ryood/Arduino_EG/CameraZOOM-20180806190456735.jpg

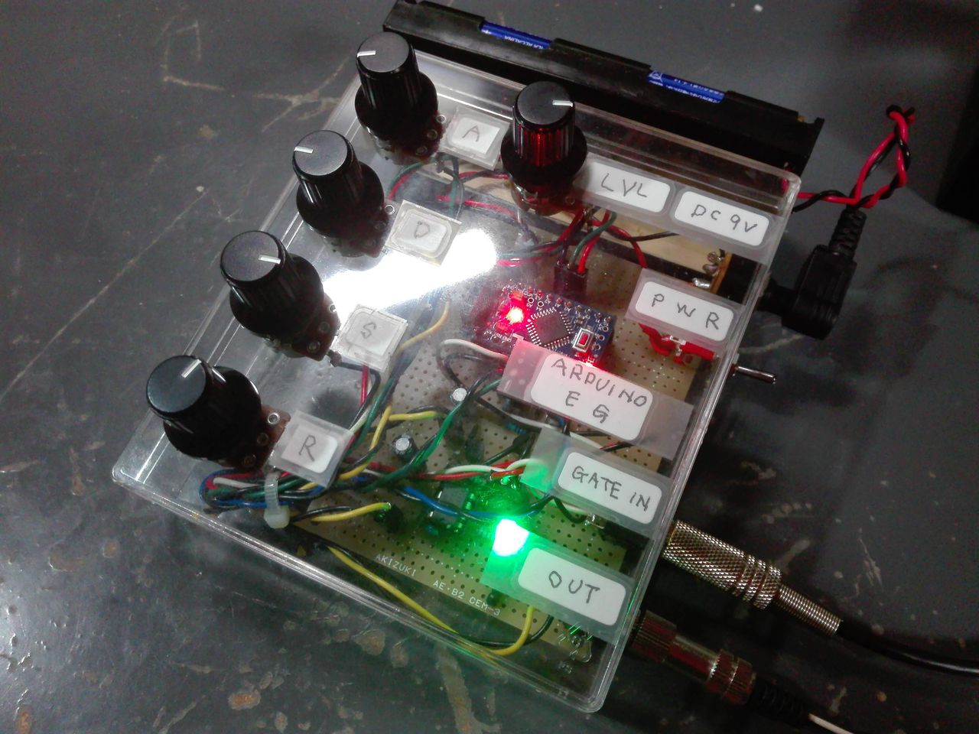
CameraZOOM-20180806190456735.jpg
