ryood/Arduino_EG/Arduino_EG_ケース内配線_ブレッドボード.png

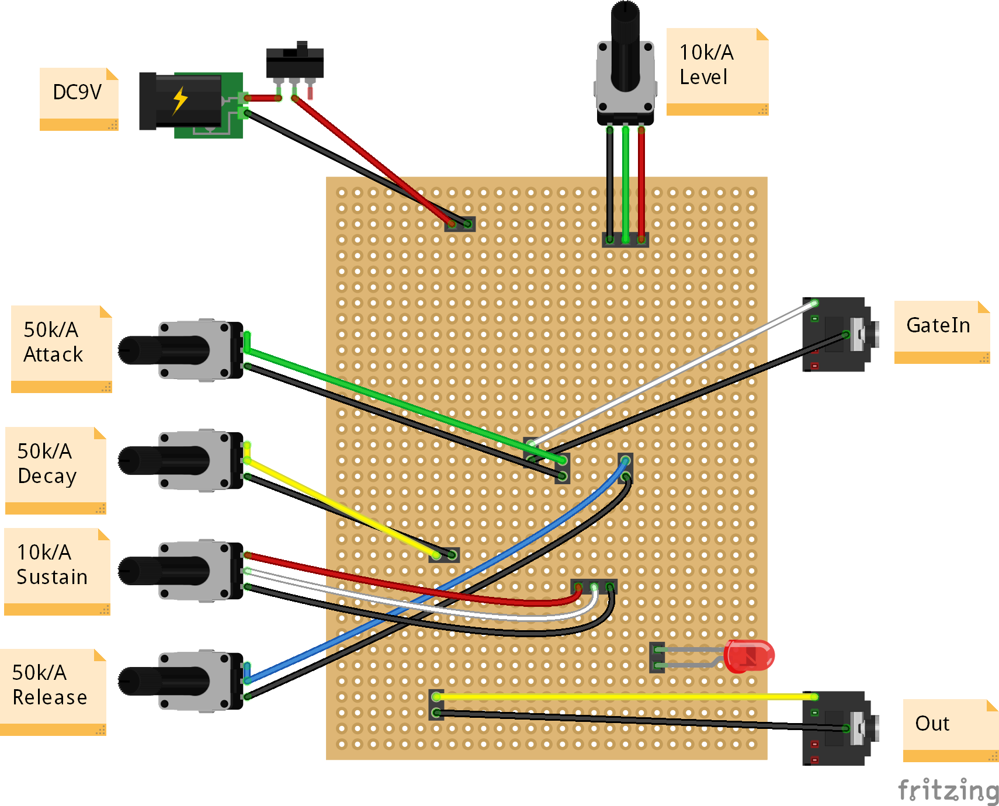
Arduino_EG_ケース内配線_ブレッドボード.png
