ryood/Arduino_EG/eagle/Arduino_EG_brd.png

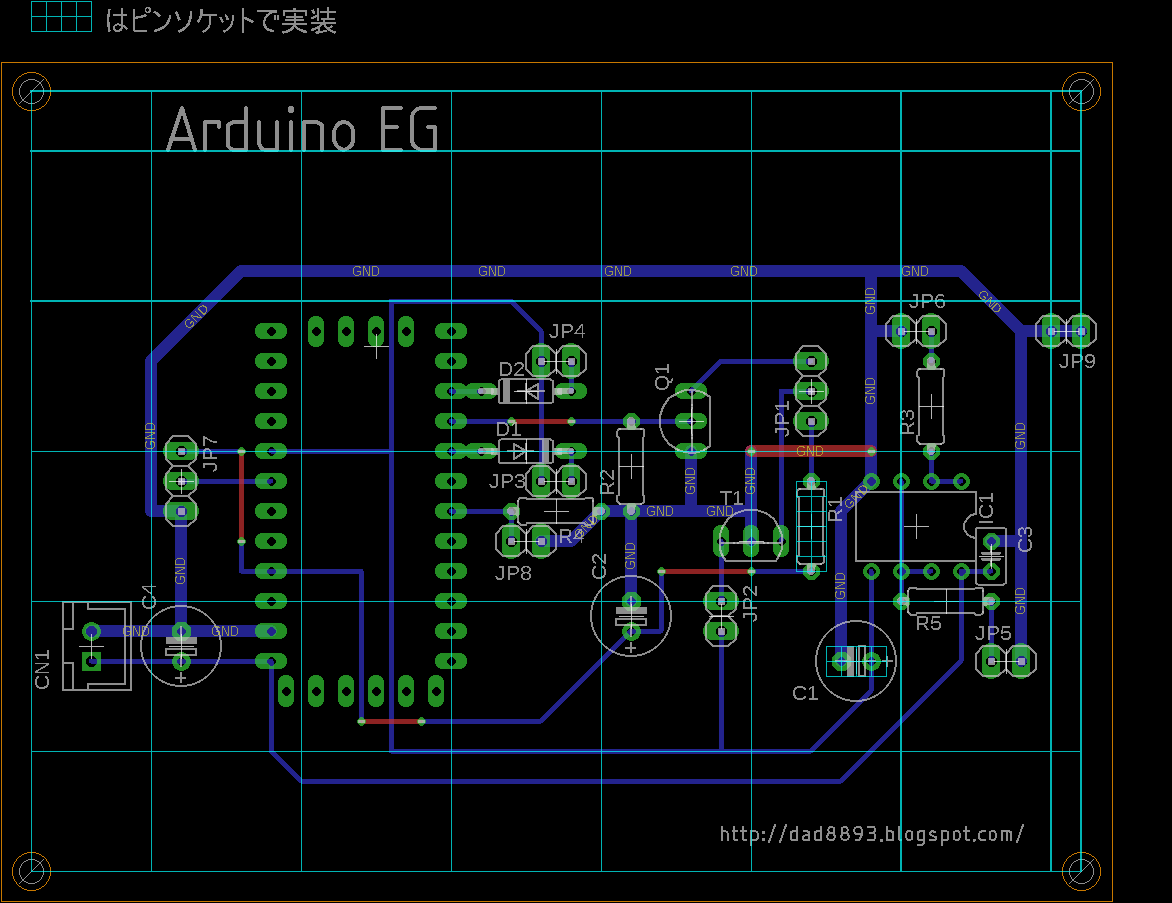
eagle/Arduino_EG_brd.png
