ryood/Arduino_EG/eagle/Arduino_EG_sch.png

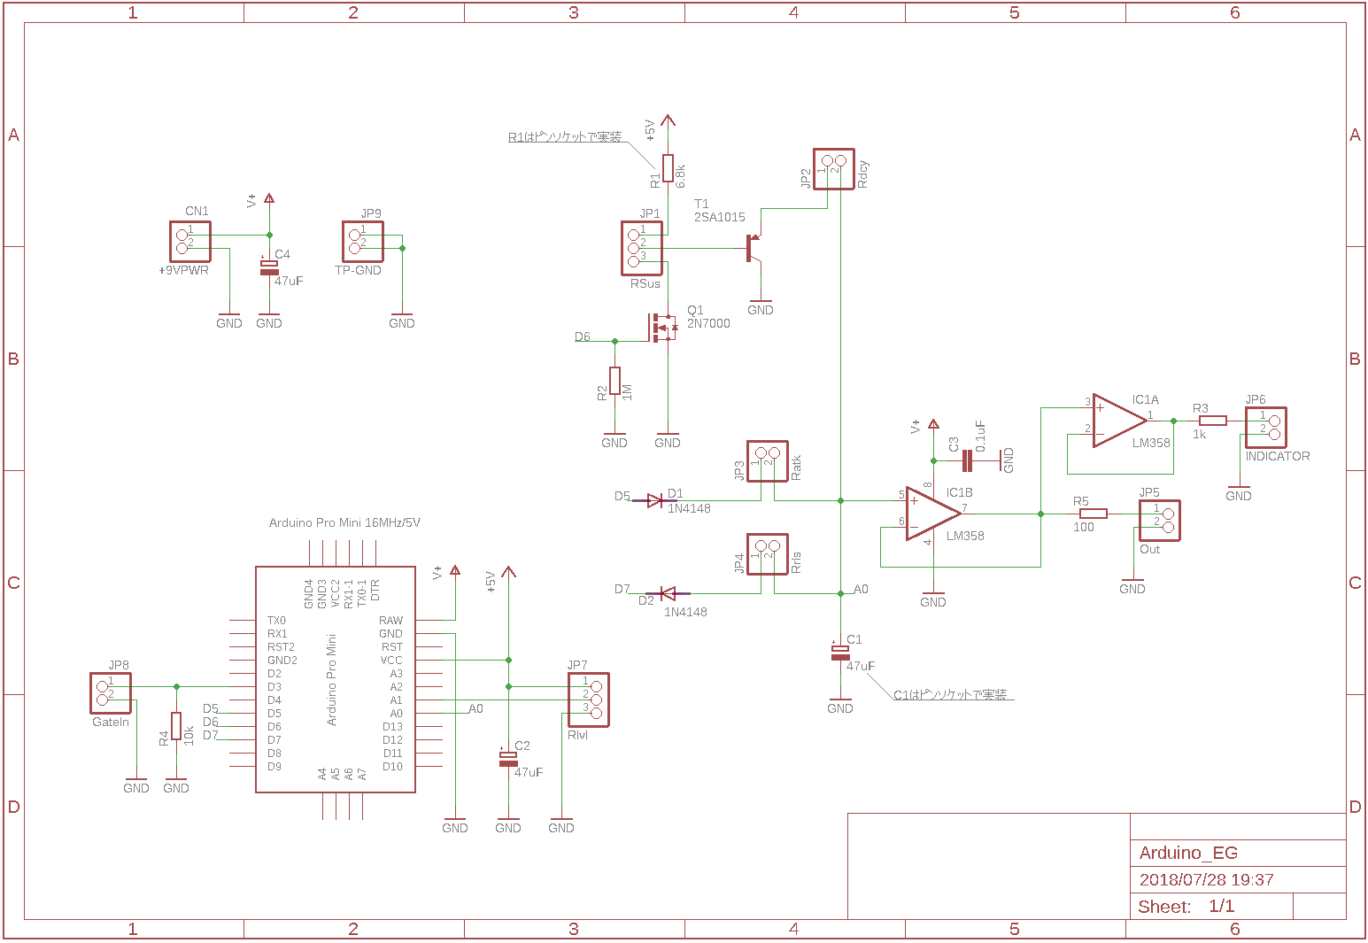
eagle/Arduino_EG_sch.png
