ryood/Arduino_EG/Envelope Generator Curve.png

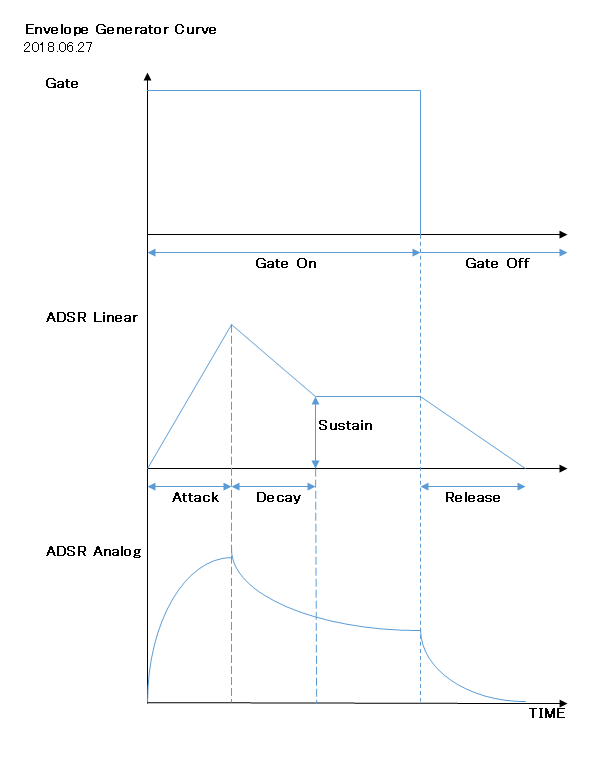
Envelope Generator Curve.png
