ryood/Arduino_EG/fritzing/Arduino_EG_r2_ブレッドボード.png

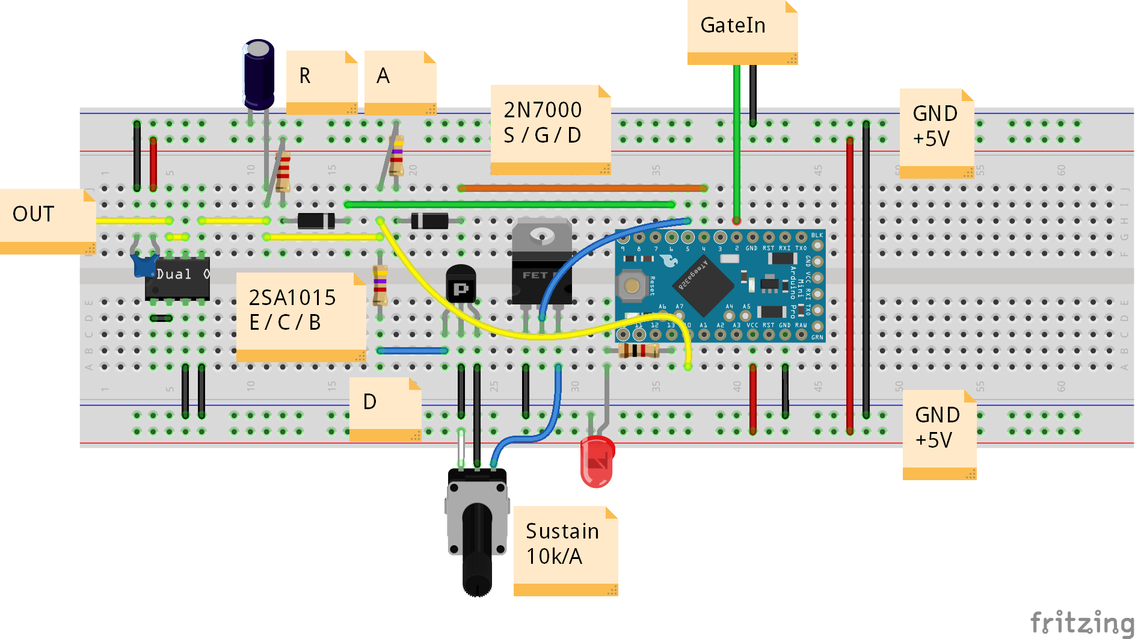
fritzing/Arduino_EG_r2_ブレッドボード.png
