ryood/Arduino_EG/fritzing/Arduino_EG_r3_ブレッドボード.png

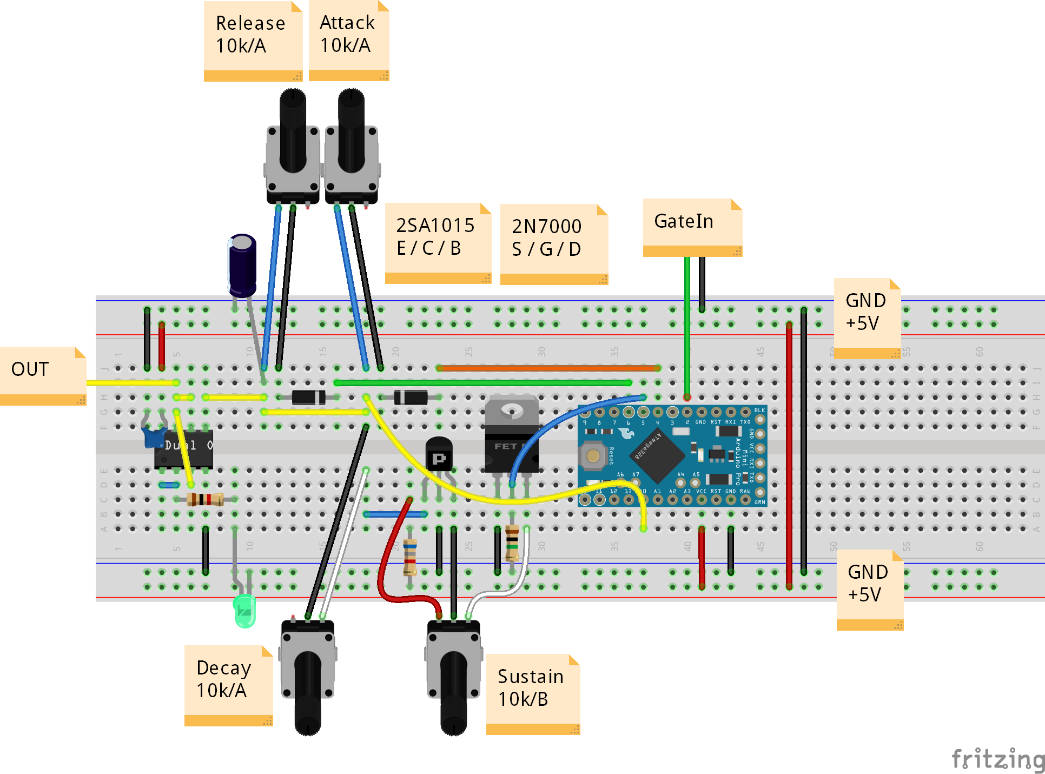
fritzing/Arduino_EG_r3_ブレッドボード.png
