ryood/Arduino_EG/資料/907-cont-gen-key-schem.gif

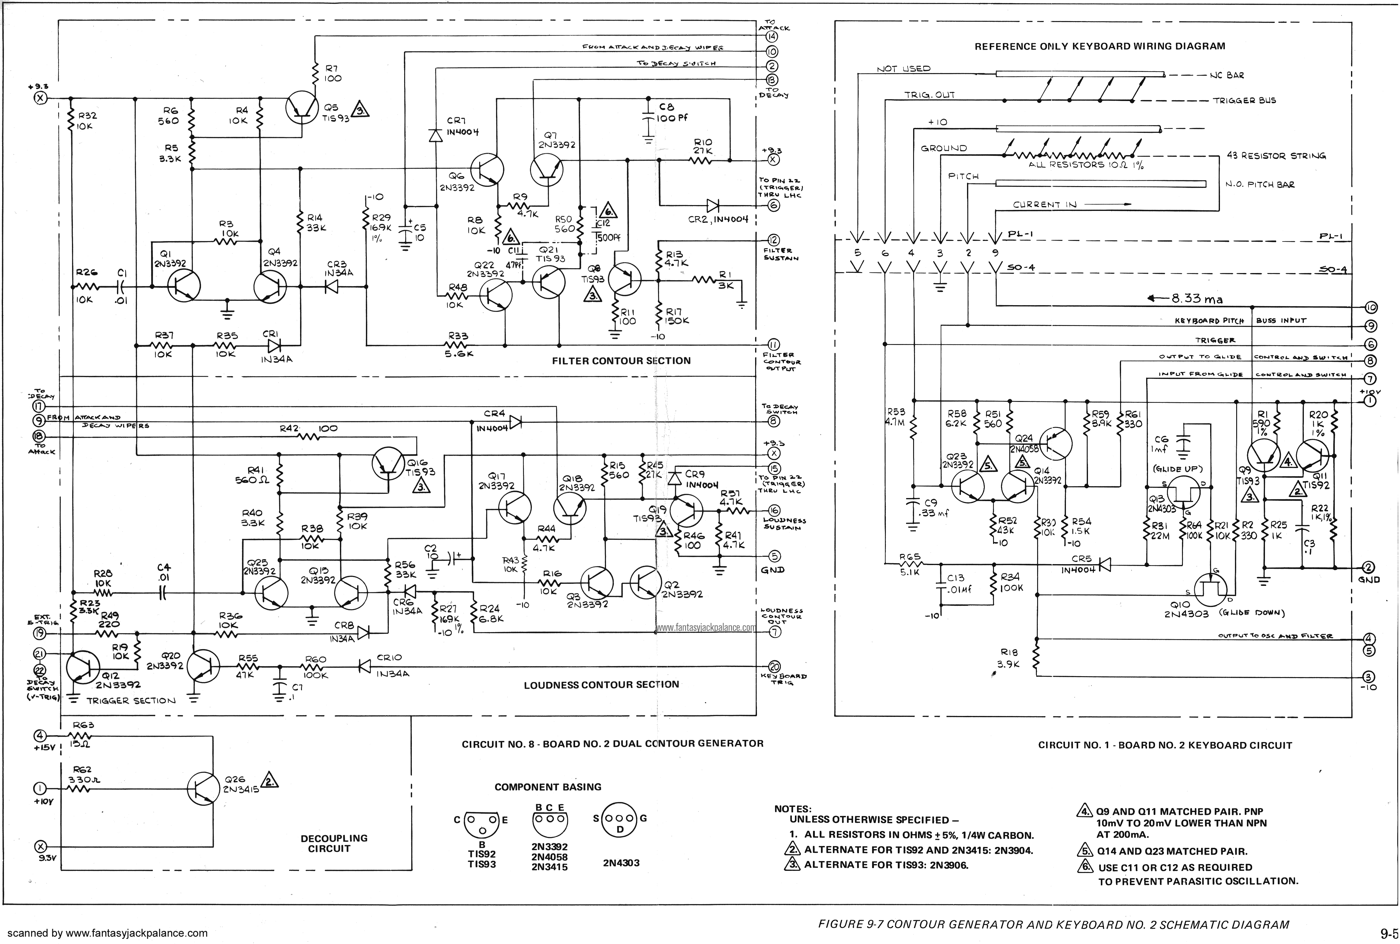
資料/907-cont-gen-key-schem.gif
