ryood/Arduino_EG/資料/ADSR555-sch.gif

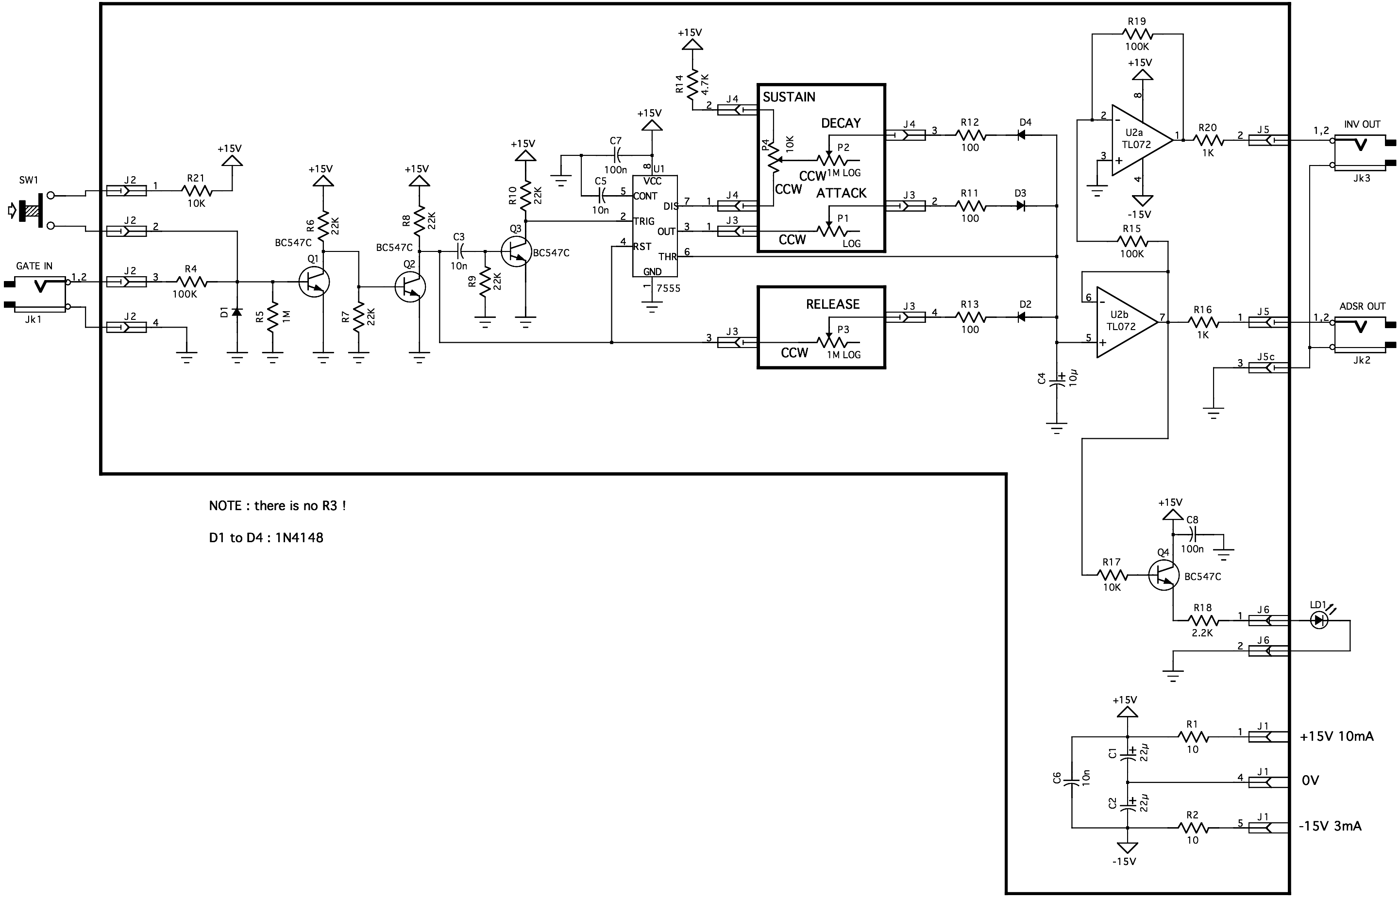
資料/ADSR555-sch.gif
