ryood/Arduino_EG/資料/adsr_160.jpg

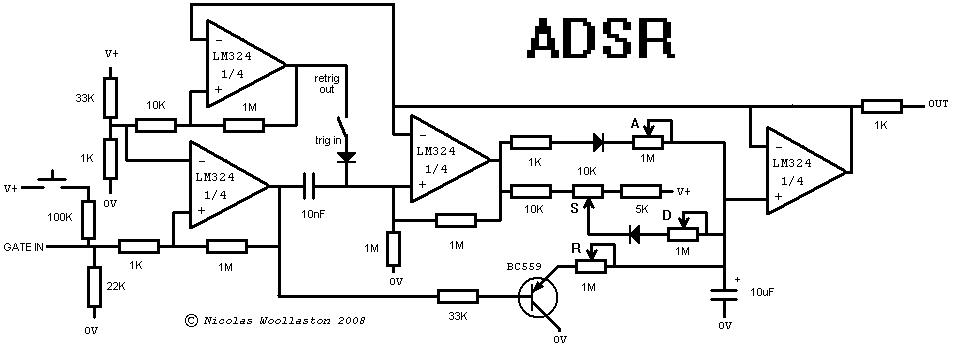
資料/adsr_160.jpg
