ryood/Arduino_EG/資料/switching-and-timing.png

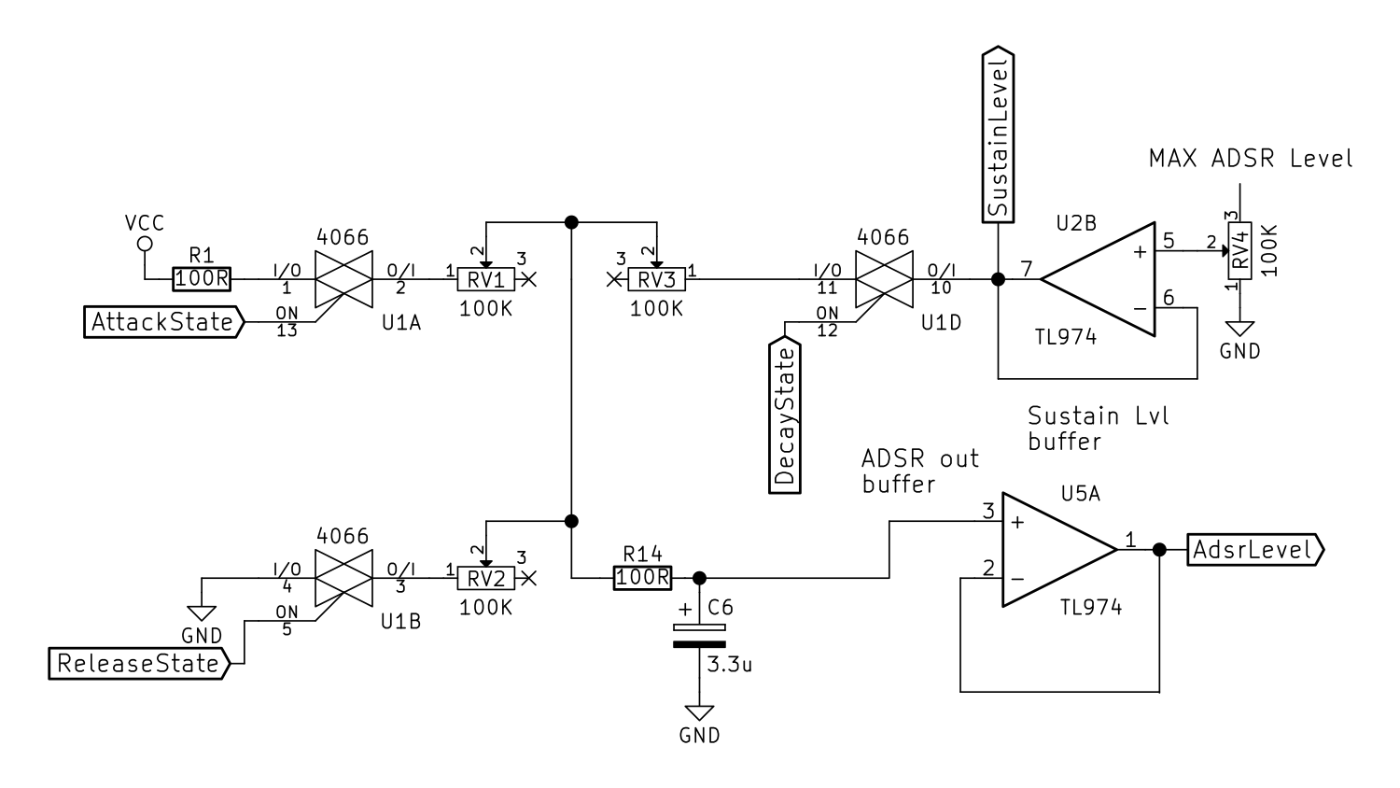
資料/switching-and-timing.png
