ryood/Arduino_EG/(list of files, cad)

Other CAD files:
case/Arduino_EG_Case.dwg
case/Arduino_EG_Case_Top.dwg
