ryood/Arduino_EG/spice/StepWave_LPF_EG.asc

C1: cap; 10uF
R1: res; 10k
V1: voltage; PWL(0 0 0.1 0 0.101 5 0.3 5 0.301 2 0.6 2 0.601 0)
Named nets: 0, OUT, IN
.tran 1
