ryood/Arduino_EG/spice/Arduino_EG_Charge_Test.asc

B1: bv; V=5-V(Gate)
C1: cap; 22u
D1: diode; 1N4148
R1: res; 100
R2: res; {Rattack}
S1: sw
V3: voltage; PULSE(0 5 0 1n 1n 0.8 1)
Named nets: Discharge, Gate, 0, OUT
.step param Rattack 10k 1k
.tran 0 10 8
.Model SW SW(Ron=10m Roff=10meg Vt=2.5)
