ryood/Arduino_EG/spice/Arduino_EG_Analog_MOS-FET.asc

B1: bv; V=5-V(Attack)
C1: cap; 22u
D1: diode; 1N4148
D2: diode; 1N4148
M1: nmos; 2N7002
Q1: pnp; QA1015
R1: res; {Rdecay}
R2: res; {Rattack}
R3: res; {15k-Rsustain}
R4: res; {Rsustain}
R5: res; {Rrelease}
R6: res; 10k
U1: UniversalOpamp2
V1: voltage; 5
V2: voltage; PULSE(0 5 0 1n 1n 0.4 0.5)
V3: voltage; PULSE(0 5 0 1n 1n 0.1 0.5)
Named nets: InvAttack, Attack, 0, OUT, VCC, Gate
.param Rattack 4.7k
.tran 0 10 9
.Model SW SW(Ron=10m Roff=10meg Vt=2.5)
.param Rdecay 2.2k
.param Rsustain 4k
.param Rrelease 2.2k
