ryood/Arduino_EG/spice/555_Monostable.asc

C2: cap; {CL}
R1: res; {RL}
R2: res; {RA}
U1: NE555
V1: voltage; 5
V2: voltage; PULSE(0 5 0 1n 1n 0.25m 0.3m)
Named nets: 0, IN, OUT, VCC
.param RA 9.1k
.param CL 0.01u
.param RL 1k
.tran 0 10m 9m
