ryood/Arduino_EG/spice/EG_Analog2_0.asc

C1: cap; 47u
C2: cap; 0.001u
C3: cap; 0.01u
D1: diode; 1N4148
D2: diode; 1N4148
D3: diode; 1N4148
D4: diode; 1N4148
Q1: pnp; QA1015
Q2: npn; QC1815
Q3: npn; QC1815
Q4: npn; QC1815
Q5: npn; QC1815
R1: res; {Rdecay}
R2: res; {Rattack}
R3: res; {Rrelease}
R4: res; {75k-Rsustain}
R5: res; {Rsustain}
R6: res; 10k
R7: res; 2.2k
R8: res; 2.2k
R9: res; 47k
R10: res; 2.2k
R11: res; 10k
R12: res; 2.2k
R13: res; 22k
R14: res; 47k
R15: res; 10k
R16: res; 4.7k
U1: NE555
U2: UniversalOpamp2
V1: voltage; 12
V2: voltage; PULSE(0 12 0 1n 1n 0.5 1)
Named nets: 555Discharge, 0, 555Out, Q4Out, VCC, Out, OUT, Gate, VEE
.param Rdecay 2k
.param Rattack 2k
.param Rrelease 2k
.tran 0 10 7
.step param Rsustain 50k 1k
