ryood/Arduino_EG/spice/EG_Analog2_0_analog.asc

B1: bv; V=V(VCC)-V(Attack)
C1: cap; 47u
D1: diode; 1N4148
D2: diode; 1N4148
Q1: pnp; QA1015
Q2: npn; QC1815
Q3: npn; QC1815
R1: res; {Rdecay}
R2: res; {Rattack}
R3: res; {Rrelease}
R4: res; {75k-Rsustain}
R5: res; {Rsustain}
V1: voltage; 12
V3: voltage; PULSE(0 12 0 1n 1n 0.2 1)
V4: voltage; PULSE(0 12 0 1n 1n 0.75 1)
Named nets: InvAttack, 0, Attack, GATE, VCC, Out, Gate
.param Rdecay 2k
.param Rattack 2k
.param Rrelease 2k
.tran 0 100 97
.step param Rsustain 50k 1k
.param V+ 12
