ryood/Arduino_EG/spice/bak/EG_Analog2_0_analog_9V.asc

B1: bv; V=V(VCC)-V(Attack)
C1: cap; 47u
D1: diode; 1N4148
D2: diode; 1N4148
Q1: pnp; QA1015
Q2: npn; QC1815
Q3: npn
R1: res; {Rdecay}
R2: res; {Rattack}
R3: res; {Rrelease}
R4: res; {100k-Rsustain}
R5: res; {Rsustain}
R6: res; 4.7k
V1: voltage; 9
V3: voltage; PULSE(0 9 0 1n 1n 0.2 1)
V4: voltage; PULSE(0 9 0 1n 1n 0.75 1)
Named nets: InvAttack, 0, Attack, GATE, VCC, Out, Gate
.param Rdecay 1k
.param Rattack 2k
.param Rrelease 2k
.tran 0 100 97
.step param Rsustain list 1k 10k 20k 30k 40k 49k
