ryood/Arduino_EG/spice/bak/EG_Analog2_0_analog_mosfet_9V_EmitterFollower.asc

B1: bv; V=V(VCC)-V(Attack)
C1: cap; 22u
C2: cap; 100u
D1: diode; 1N4148
D2: diode; 1N4148
M1: nmos; 2N7002
Q1: npn; QC1815
Q2: npn
R1: res; {Rdecay}
R2: res; {Rattack}
R3: res; {Rrelease}
R4: res; {100k-Rsustain}
R5: res; {Rsustain}
R6: res; 1k
R7: res; 100k
R8: res; 1k
V1: voltage; 9
V3: voltage; PULSE(0 9 0 1n 1n 0.2 1)
V4: voltage; PULSE(0 9 0 1n 1n 0.75 1)
Named nets: InvAttack, Attack, GATE, 0, Out, VCC, Gate
.param Rdecay 2k
.param Rattack 2k
.param Rrelease 2k
.tran 0 100 98
.step param Rsustain list 1k 25k 50k 75k 99k
.param V+ 12
