ryood/Arduino_EG/(list of files, drawings)

Other design files:
fritzing/Arduino_EG.fzz
fritzing/Arduino_EG_Attack_Charge_Test.fzz
fritzing/Arduino_EG_Impl_Test.fzz
fritzing/Arduino_EG_r2.fzz
fritzing/Arduino_EG_r3.fzz
fritzing/Arduino_EG_ケース内配線.fzz
