ryood/Arduino_EG/fritzing/Arduino_EG_Attack_Charge_Test_ブレッドボード.png

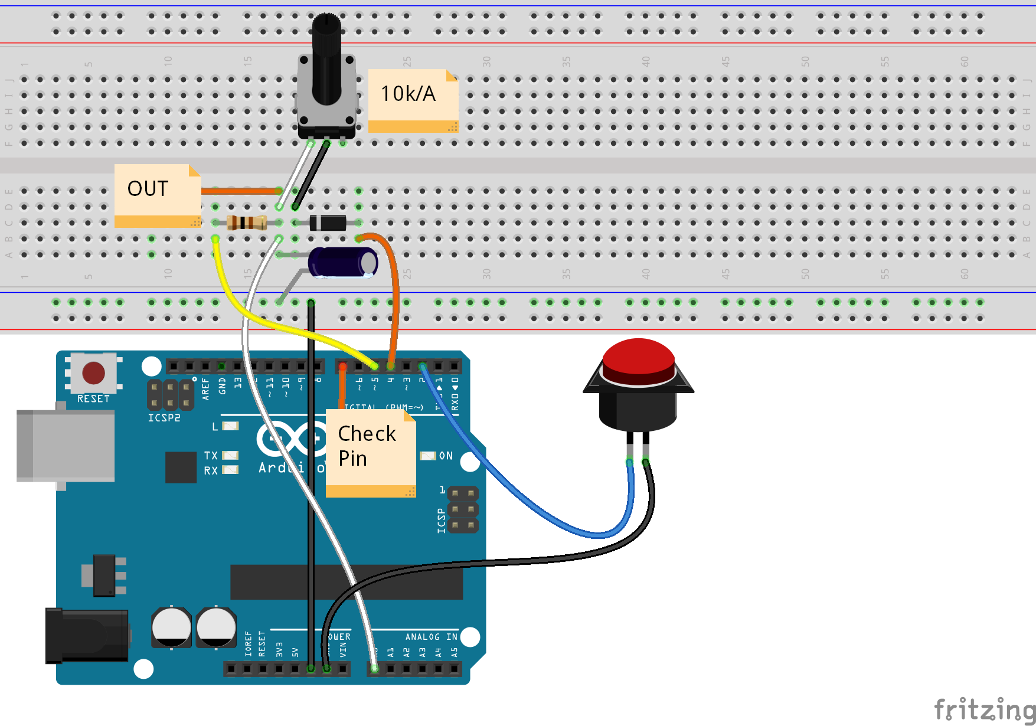
fritzing/Arduino_EG_Attack_Charge_Test_ブレッドボード.png
