ryood/Arduino_EG/fritzing/Arduino_EG_Impl_Test_ブレッドボード.png

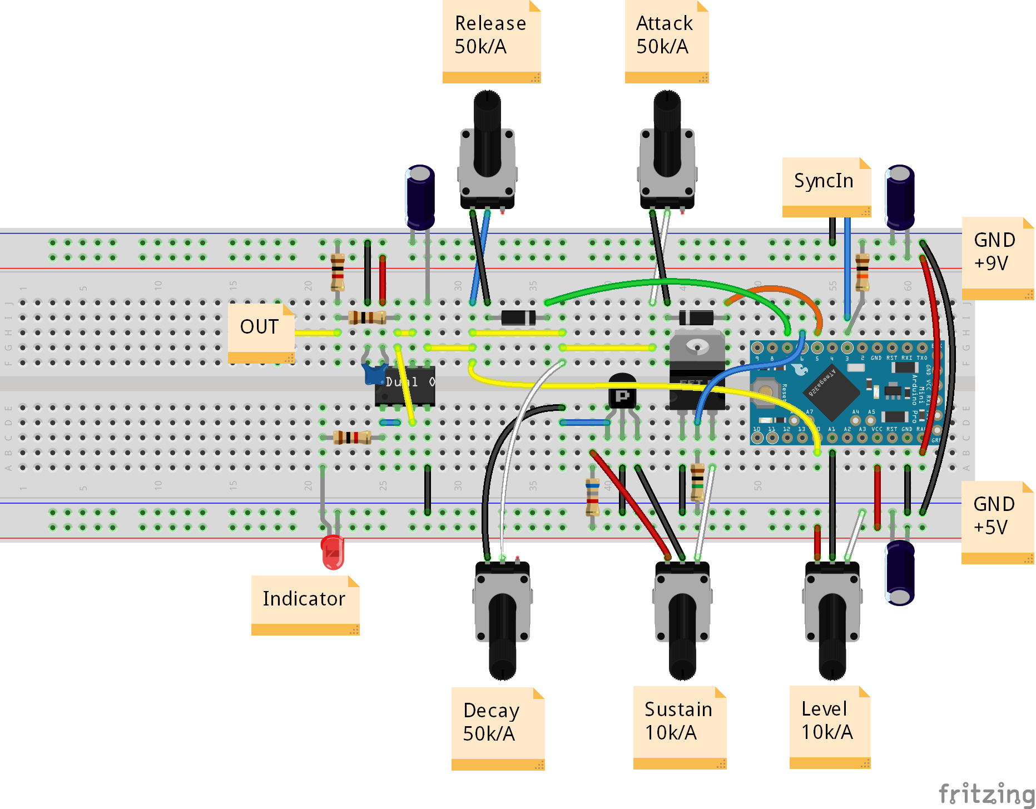
fritzing/Arduino_EG_Impl_Test_ブレッドボード.png
