ryood/Arduino_EG/(commit log)

2018-07-09 Arduino EG 構想
    [Arduino_EG.fzz, Arduino_EG_r2.fzz]
2018-07-09 Update: flitzing files, arduino sketch
    [Arduino_EG_r3.fzz]
2018-07-23 Add eagle files
    [Arduino_EG.brd, Arduino_EG.sch, Arduino_EG_Impl_Test.fzz]
2018-07-25 Update eagle files
    [Arduino_EG.brd, Arduino_EG.sch, Arduino_EG_Impl_Test.fzz]
2018-07-25 Update Arduino sketch
2018-07-28 Update Arduino sketch, Eagle files
    [Arduino_EG.brd, Arduino_EG.sch]
2018-07-28 Update Arduino_EG ピンアサインを変更
    [Arduino_EG_Impl_Test.fzz]
2018-08-11 Add case design
    [Arduino-EGテスト表.xlsx, Arduino_EG_Case.dwg, Arduino_EG_Case_Top.dwg, Arduino_EG_ケース内配線.fzz]
